jorgecrce/IOT-Rover/Photos/DSC_0085.JPG

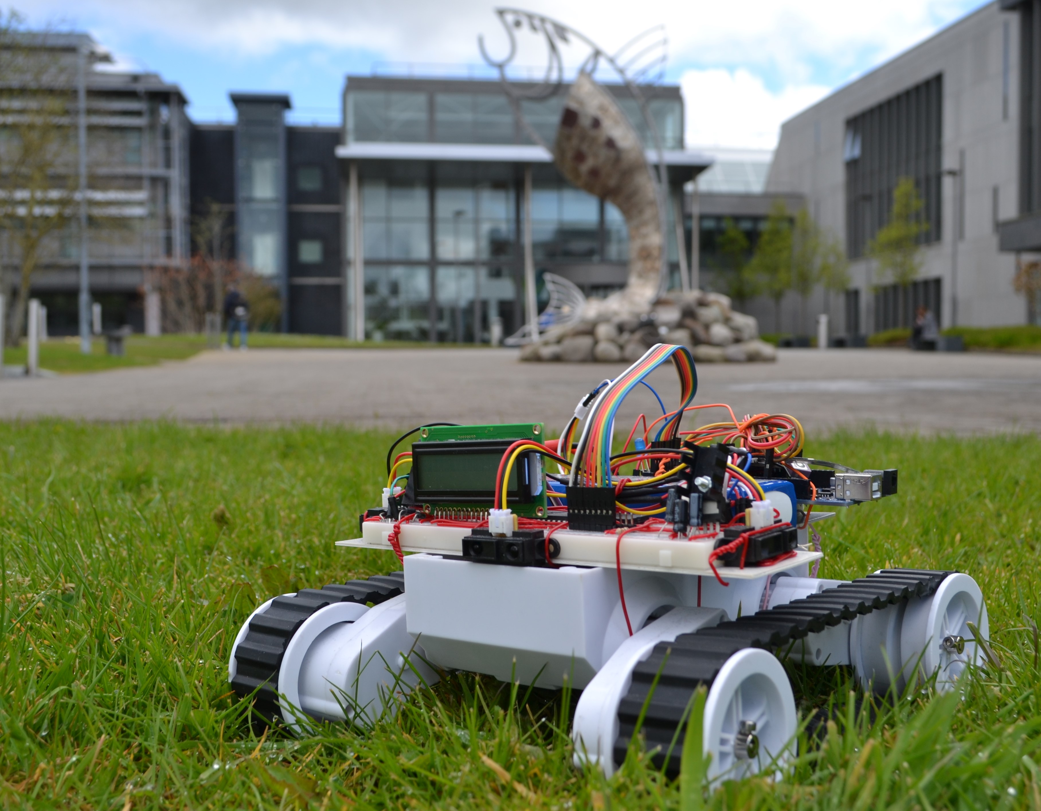
Photos/DSC_0085.JPG
