jorgecrce/IOT-Rover/Photos/DSC_0082.JPG

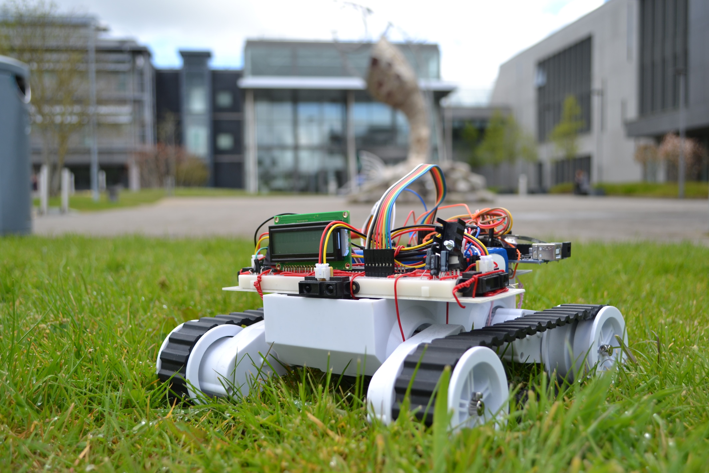
Photos/DSC_0082.JPG
