jorgecrce/IOT-Rover/Documents/Block diagram-Final.Jorge.Crespo.docx

# Block diagram

LCD 16x2 3.3v

GPS+GPRS module

Power regulator

5V

Power regulator 3.3V

Battery

Distance sensor

Distance sensor

Distance sensor

L298 dual H bridge

Right

Motor

Left

Motor

PIC microcontroller

Jorge Crespo. Electronics year 3
