jorgecrce/IOT-Rover/Documents/poster - Portrait-A1-Final.pdf

# Development and build of a rover car

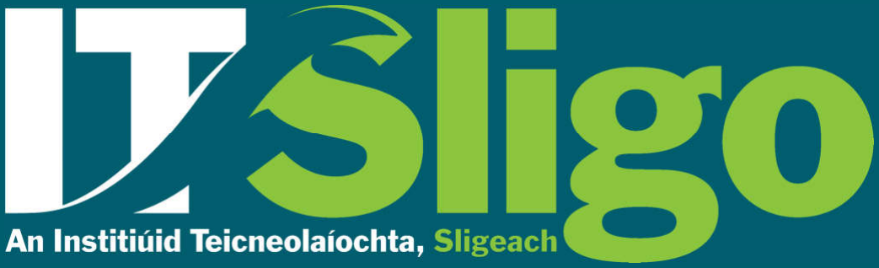
[picture p42: figure]

# With Internet and GPS connecon

### Jorge Crespo Celdrán — Instute of Technology Sligo

# Project info

The aim of this project was to develop a rover connected to the internet (Internet of things) through a mobile internet connecon. The enre project (code, hardware design, etc.) is to be made available as an open source project for others to learn from. Using the internet and a remote server, commands are sent to the rover from any device from anywhere in the world. The commands that can be sent includes orders to move the vehicle in different direcons (i.e. to have full control) and also an order to acvate an autonomous mode, which moves the vehicle while avoiding obstacles.
In order to avoid the obstacles, the rover has three distance sensors which informs the microcontroller of the distance to the objects, and an algorithm in the rover changes the direcon to avoid obstacles.
The system is checking connuously if there is an available GPS signal, and if it finds a signal, sends the coordinates (each minute) to a remote server, and from a webpage we can see this coordinates drawn in a map.

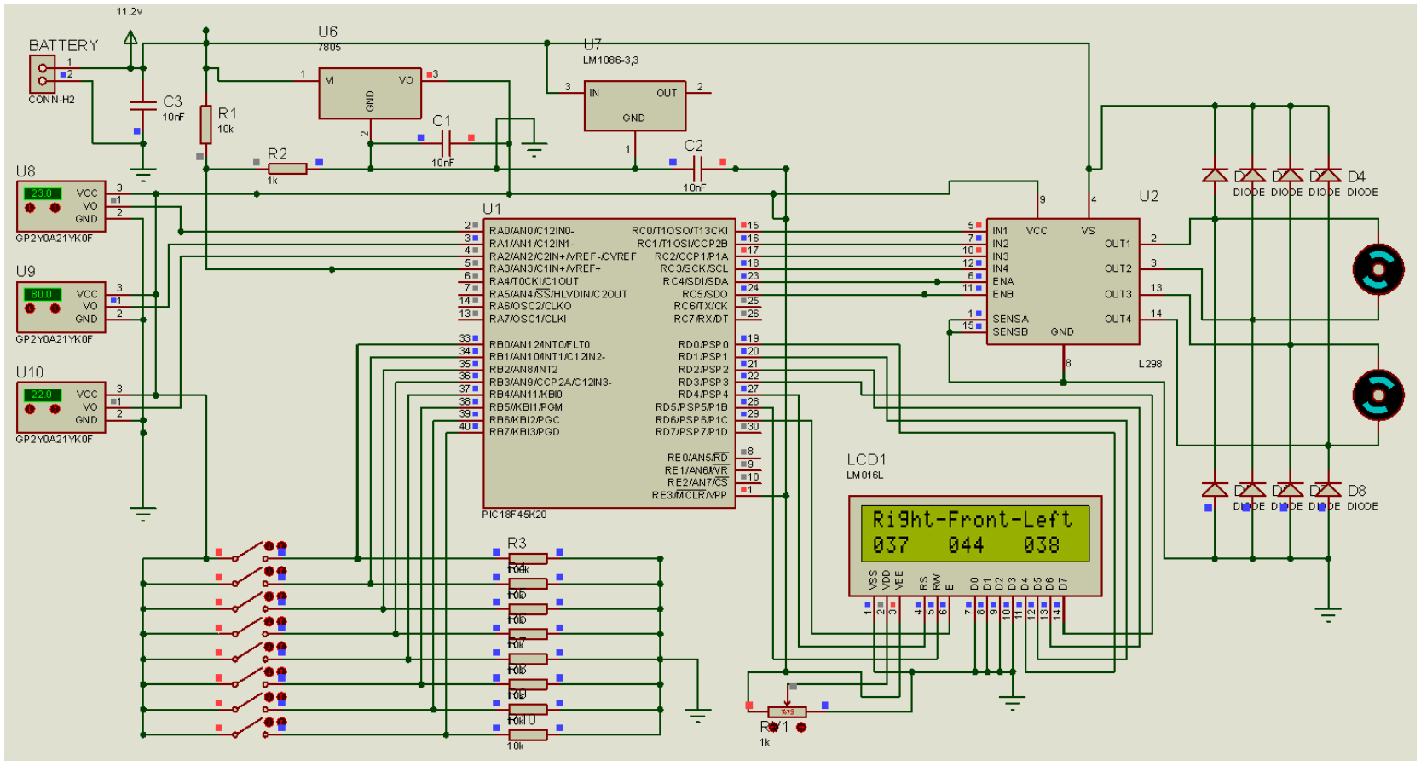
[picture p43: figure]

# Conclusions

During the execuon of this project, many areas studied as part of my degree in electronic engineering have been ulized, including mounng analog and digital electronic components and developing all the program for the PIC microcontroller and for the Arduino. This project has also covered areas outside the scope of my degree, for example informacs and automaon and mechatronics engineering.

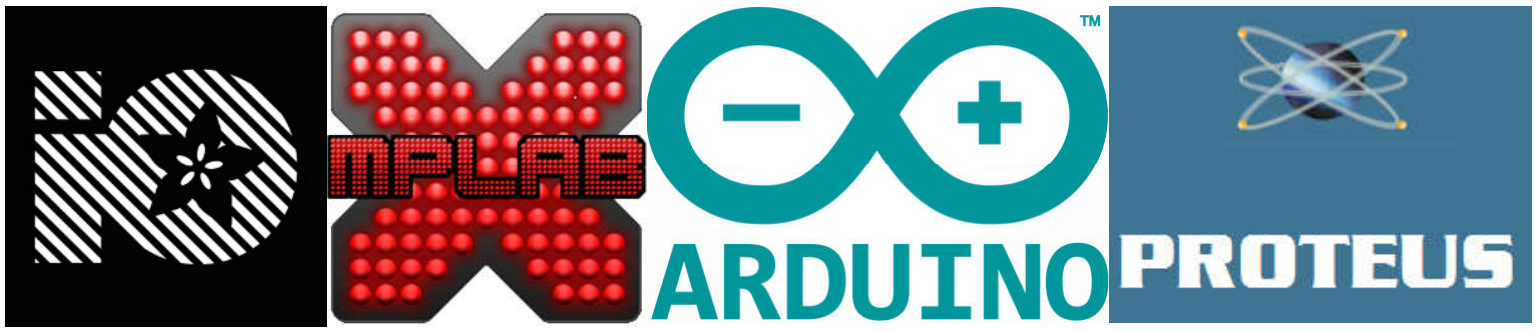
[picture p44: figure]
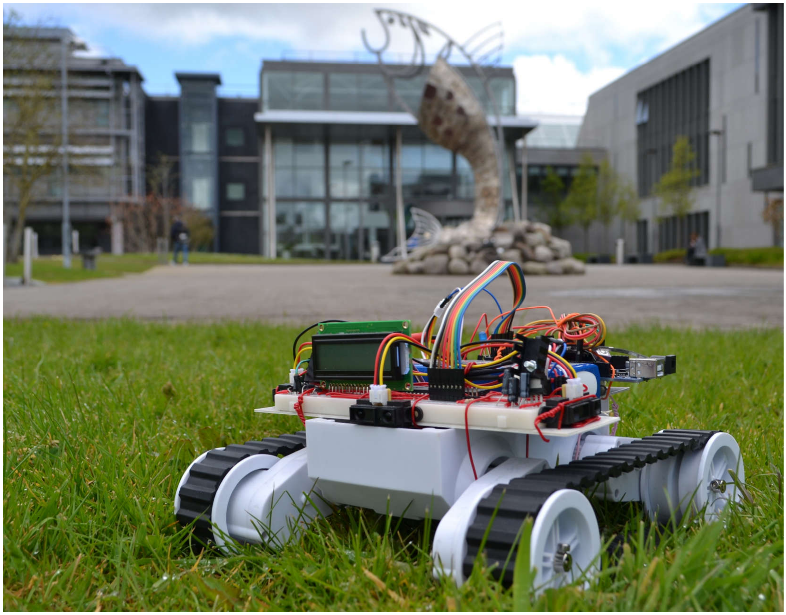
[picture p45: figure]

# Extra informaon

You can watch a video, download the code, the full report, and all the documentaon related with this project in the GitHub repository: www.github.com/jorgecrce/IOT-Rover

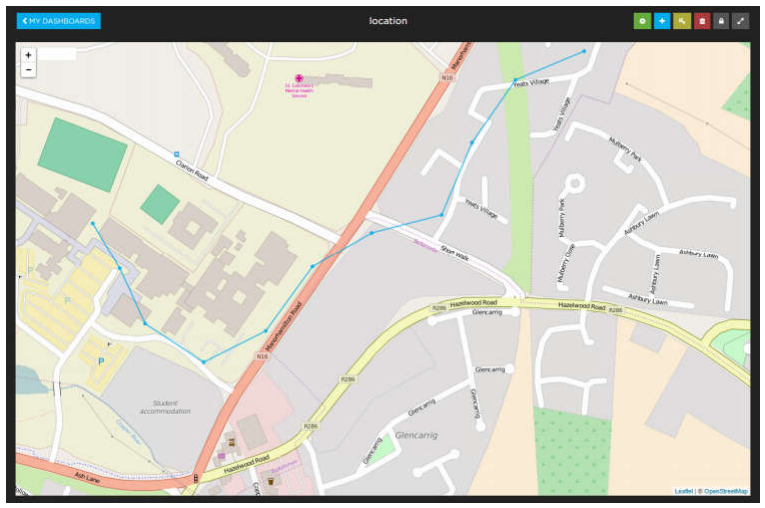
[picture p46: figure]

Contact details:
Jorge Crespo Celdrán
jorgecrce@gmail.com
+34 616 705 138


Skills Gained • Design and development of circuits

- Development of soware for the PIC
- Development Soware for the Arduino
- | Understanding | & | Programming | the
interacons between the server & Arduino
- | Understanding | & | Programming | the
interacon between the Arduino & the PIC
- Develop User Interface for the webpage
- Build the components in the chassis
- Manual and autonomous modes
- Tracking by GPS in map

# Method

In the diagram below, one can observe the different components and the connecons. Note that the power wires have not been drawn to keep the diagram easy to read.
The PIC receives instrucons from the Arduino, which receives data from the GPRS and GPS module. The PIC also receives data from the distance sensors and sends orders to the motor controller and to the LCD module.
