jorgecrce/IOT-Rover/Photos/DSC_0071.JPG

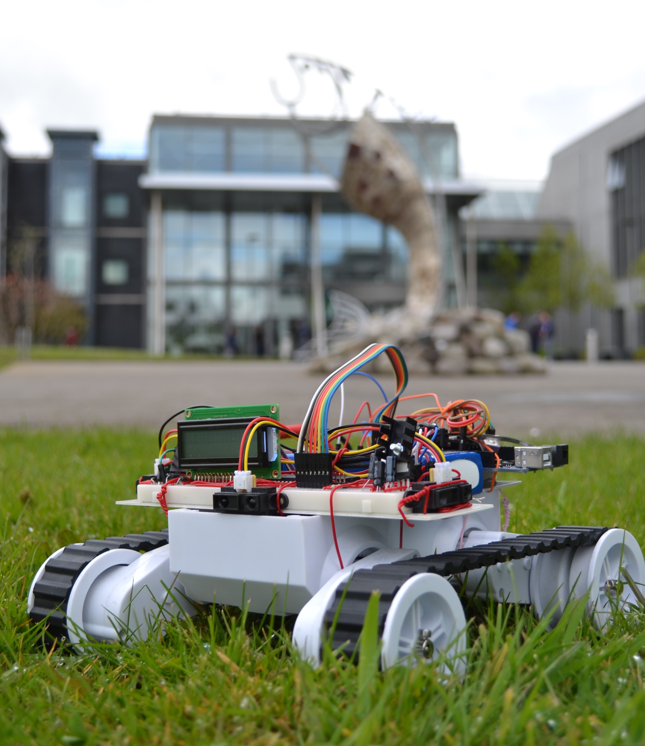
Photos/DSC_0071.JPG
