jorgecrce/IOT-Rover/Photos/DSC_0072.JPG

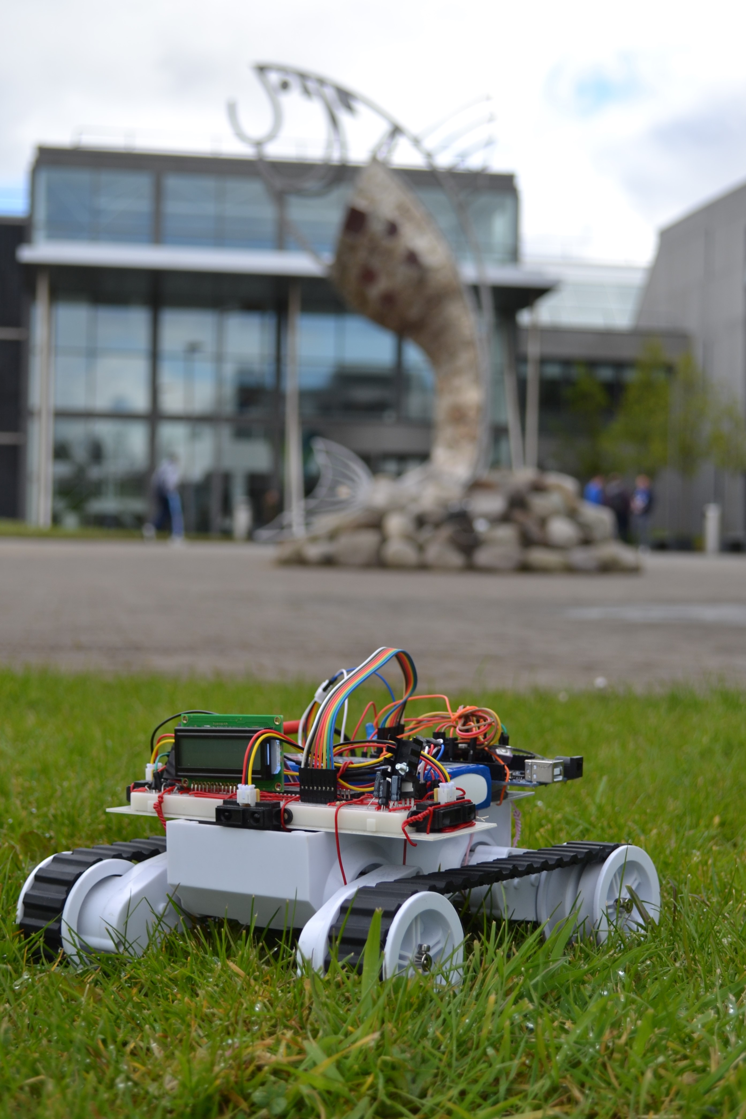
Photos/DSC_0072.JPG
