jorgecrce/IOT-Rover/Photos/DSC_0073.JPG

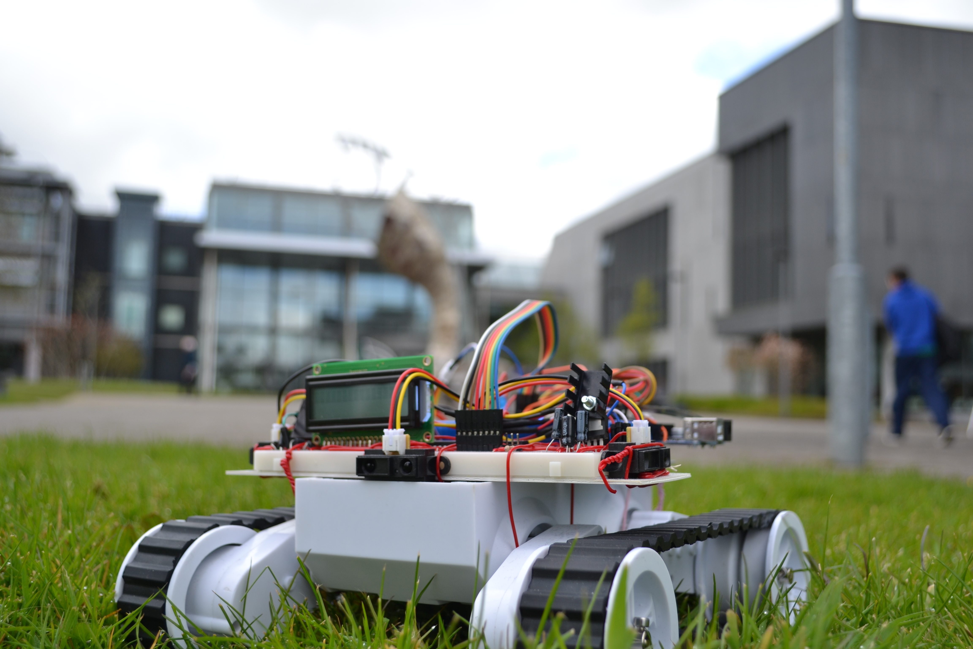
Photos/DSC_0073.JPG
