jorgecrce/IOT-Rover/Photos/DSC_0075.JPG

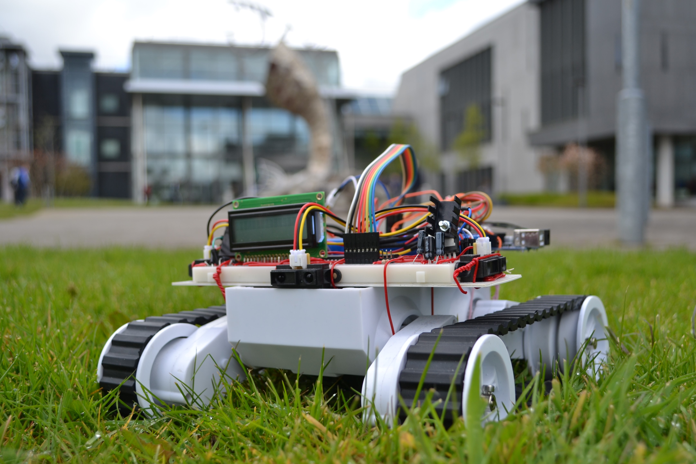
Photos/DSC_0075.JPG
