jorgecrce/IOT-Rover/Photos/DSC_0081.JPG

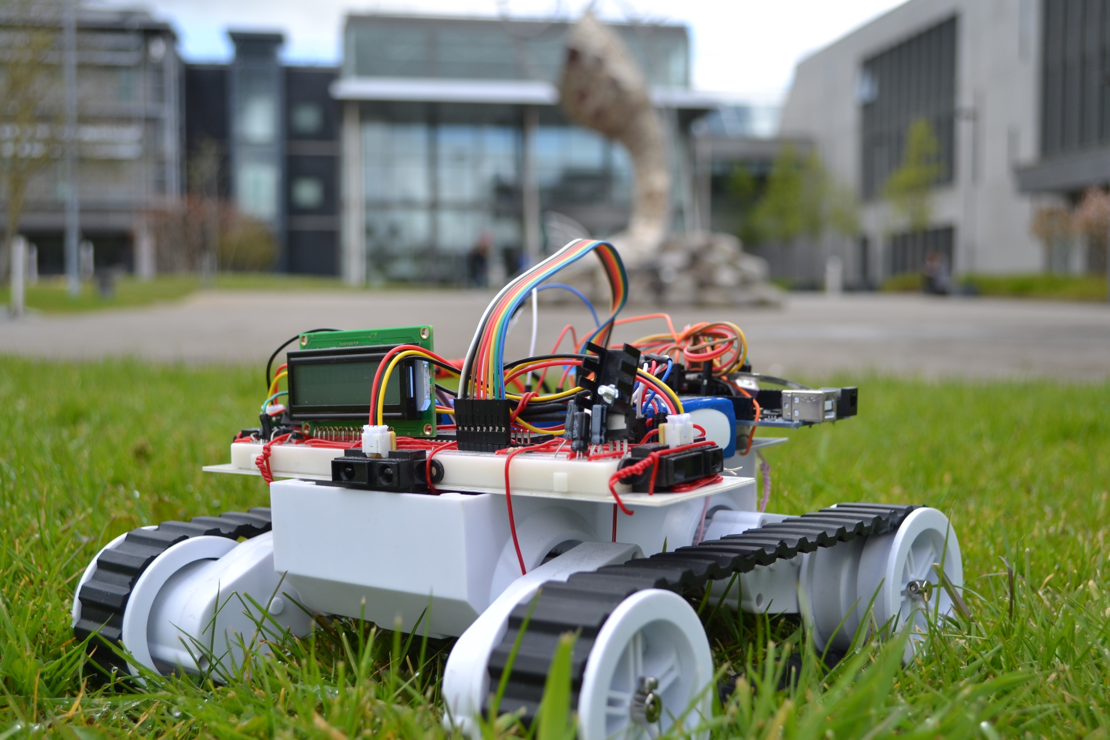
Photos/DSC_0081.JPG
