jorgecrce/IOT-Rover/Photos/DSC_0084.JPG

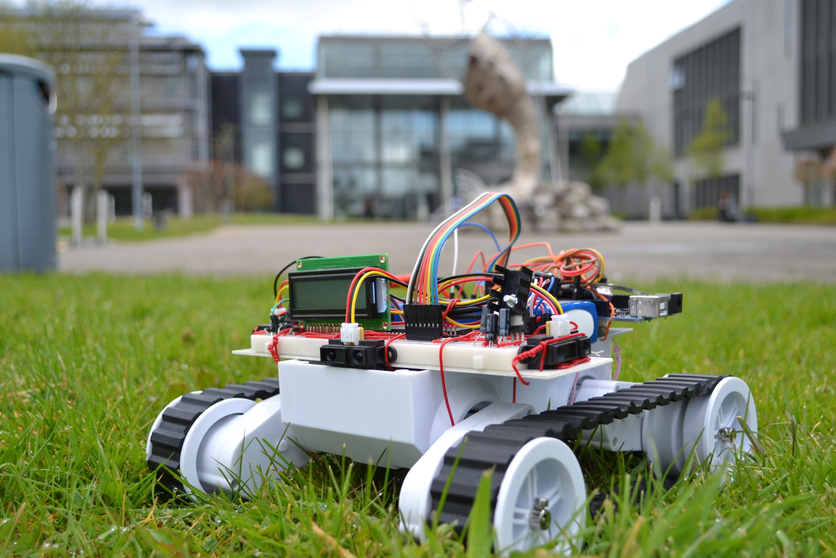
Photos/DSC_0084.JPG
