jorgecrce/IOT-Rover/(list of files, cad)

Other CAD files:
MPLab-X/Rover.X/dist/XC8_18F87K22/production/Rover.X.production.obj
MPLab-X/Rover.X/l.obj
