jorgecrce/IOT-Rover/(list of files, drawings)

Other design files:
Proteus/design0.2s.pdsprj
Proteus/design0.3s.pdsprj
Proteus/design0.4s.pdsprj
