jorgecrce/IOT-Rover/MPLab-X/Rover.X/myutils.h

/* 
 * File:   myutils.h
 * Author: Avinash
 *
 * Created on 6 June, 2013, 12:30 PM
 */

#ifndef MYUTILS_H
#define	MYUTILS_H

#ifdef	__cplusplus
extern "C" {
#endif

#define _CONCAT(a,b) a##b
#define _CONCAT2(port,pos)  TRIS##port##bits.TRIS##port##pos
#define _CONCAT3(port,pos)  R##port##pos
#define PORT(x) _CONCAT(PORT,x)
#define TRIS(x) _CONCAT(TRIS,x)
#define TRISBIT(__port,__pos) _CONCAT2(__port,__pos)
#define PORTBIT(__port,__pos) _CONCAT3(__port,__pos)

#ifdef	__cplusplus
}
#endif

#endif	/* MYUTILS_H */
