jorgecrce/IOT-Rover/(commit log)

2016-02-09 V0.1. PWM and LCD working
    [PWMLab.X.production.obj, design0.2s.pdsprj, l.obj]
2016-02-09 v0.1001 Minor changes
    [PWMLab.X.production.obj, Rover.X.production.obj, design0.2s.pdsprj]
2016-02-09 v0.15. Added module to read distance
    [Rover.X.production.obj, design0.2s.pdsprj]
2016-02-16 0.2. Serial and driver libraries added
    [Rover.X.production.obj, design0.2s.pdsprj]
2016-02-23 Minor changes
    [design0.2s.pdsprj]
2016-04-18 V1.0!
    Added Arduino and support for IO.adafruit.com
    [Rover.X.production.obj, design0.3s.pdsprj]
2016-04-21 V1.01. Minor Improvements
    GPS track + Remote activation of autonomous mode.
    [Rover.X.production.obj]
2016-04-21 1.02 Code commented!
    [Rover.X.production.obj]
2016-04-21 V1.03. Proteus more clean :+1: and Arduino without Spanish coments :-1:
    [design0.3s.pdsprj]
2016-05-02 v1.04. Added documentation
    [design0.4s.pdsprj]
2016-05-05 1.11. Added videos and minor Arduino changes
    [design0.4s.pdsprj]
